GillesLACAUD/OPLA-OTHER-FILES/readme.md

______________________________________
 READ ME
 ______________________________________
