GillesLACAUD/OPLA-OTHER-FILES/05 Design/readme.md

______________________________________
Readme DESIGN NEXTION SCREEN
______________________________________

We can have two  different Nextion 2.4" screen

The Old one have a blue board for this one use the ES32_V2.HMI
BASIC SERIE NX3224T024_011

The new one is yellow use the ESP32V2_NEWSCREEN.HMI
DISCOVERY SERIE NX3224F024_11

The Nextion can be update with the nextion editor but you will need an USB to UART converter
Or you can generate the tft file in the editor, store it in the root folder of a SD-Card, insert this SD Card in the Nextion screen
then boot the nextion screen. 

Nextion editor and more informations here:
https://nextion.tech/
