GillesLACAUD/OPLA-OTHER-FILES/01 Hardware/IO_MAPPING.xlsx

P2 | IO21
 | IO22 | Midi RX
 | IO19 | Midi Tx
 | IO23 | Nextion TX
 | IO18 | Nextion Rx
 | IO5 | Arduino Tx
P3 | VDD
 | RXD0 | Download USB
 | TXD0 | Download USB
 | RST
 | IO0
P1 | JT MTDO
 | JT MTCK
 | IO12
 | IO14
