GillesLACAUD/OPLA-OTHER-FILES/05 Design/Acceuil.jpg

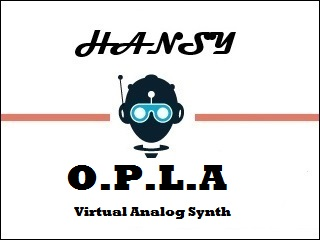
05 Design/Acceuil.jpg
