GillesLACAUD/OPLA-OTHER-FILES/08 Documentation/OPLA DIY MANUAL V1.2.pdf

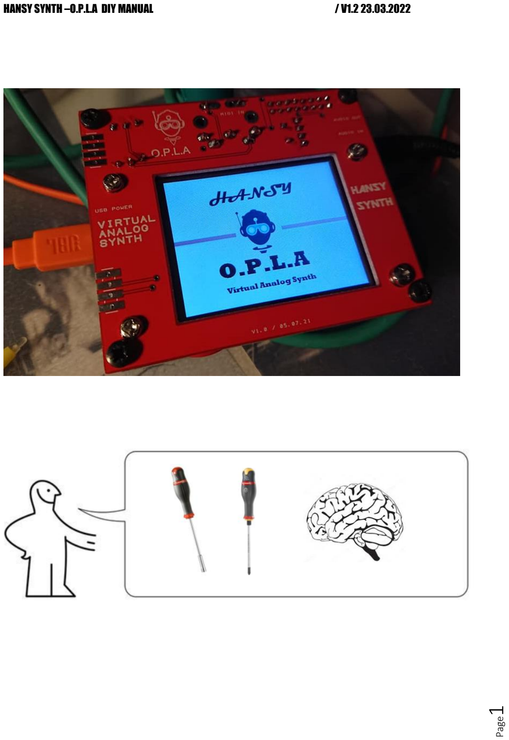
[picture p2: page 1]

HANSY SYNTH –O.P.L.A DIY MANUAL | / V1.2 23.03.2022

Page

1

Page

2

### Contents

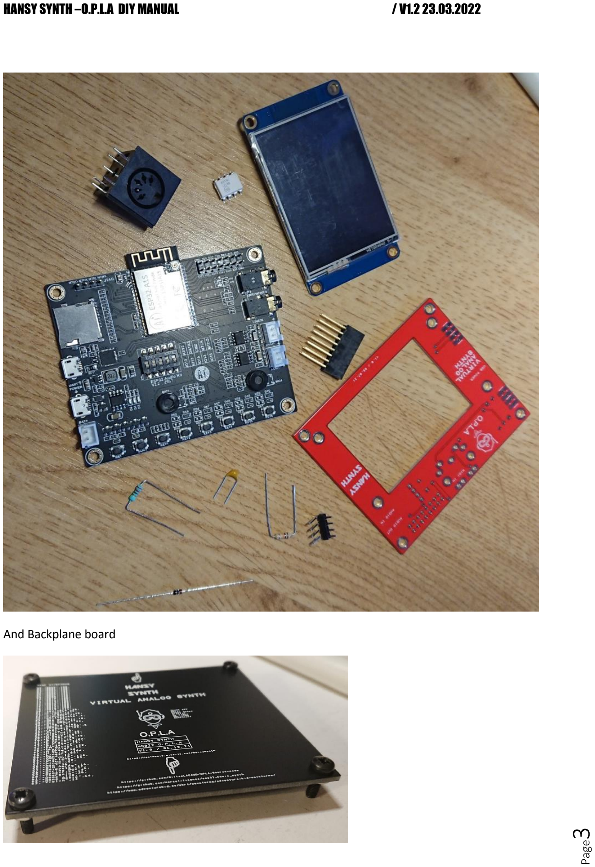
[picture p3: page 3]

Page

3

And Backplane board

Page

4

### BOM

DESIGNATION | QT
Screw M3*16 | 12
Nuts M3 | 20
Spacer M3*20 | 4
| DESIGNATION | QT
R1 | 200Ohm Resistor 1/4W | 1
R2 | 10KOhm Resistor 1/4W | 1
D1 | 1N4148 Diode | 1
C1 | 100nf Capacitor | 1
Q1 | 6N137 Optocoupleur | 1
PL1 | Four pin right angle connector | 1
| Midi 5 pin connector | 1
J1 | 2*8 pins PC104 Connector | 1
| Nextion screen | 1
| Hansy Synth HS021 Board | 1
| Hansy Synth HS022 Board (backplane) | 1
| ESP32 Audio Kit | 1
| Micro SD card < 64Go + SD support | 1
| Pen for the screen | 1
| USB cable | 1

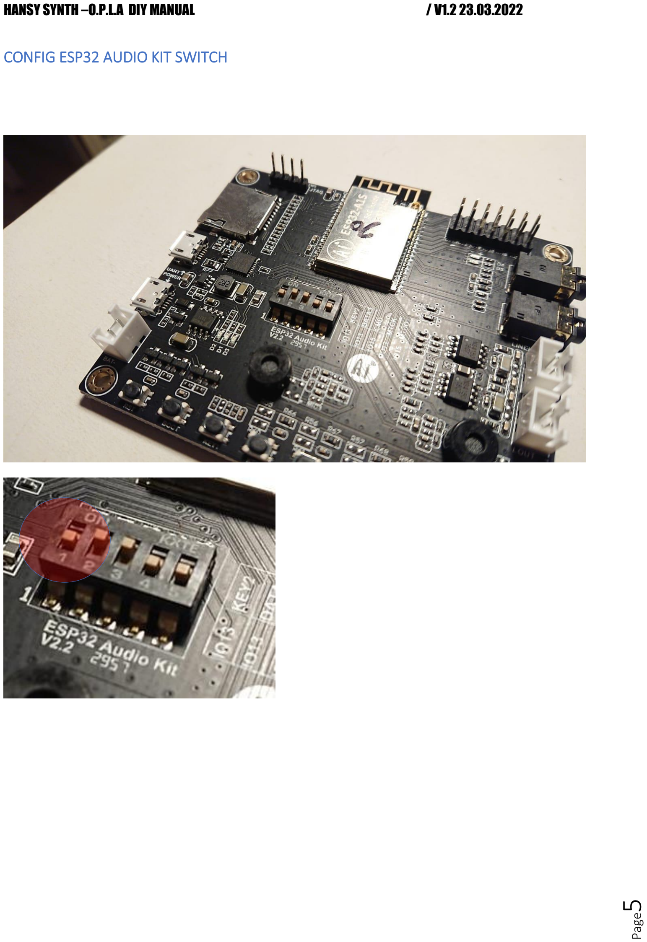
[picture p4: page 5]

Page

5

### CONFIG ESP32 AUDIO KIT SWITCH

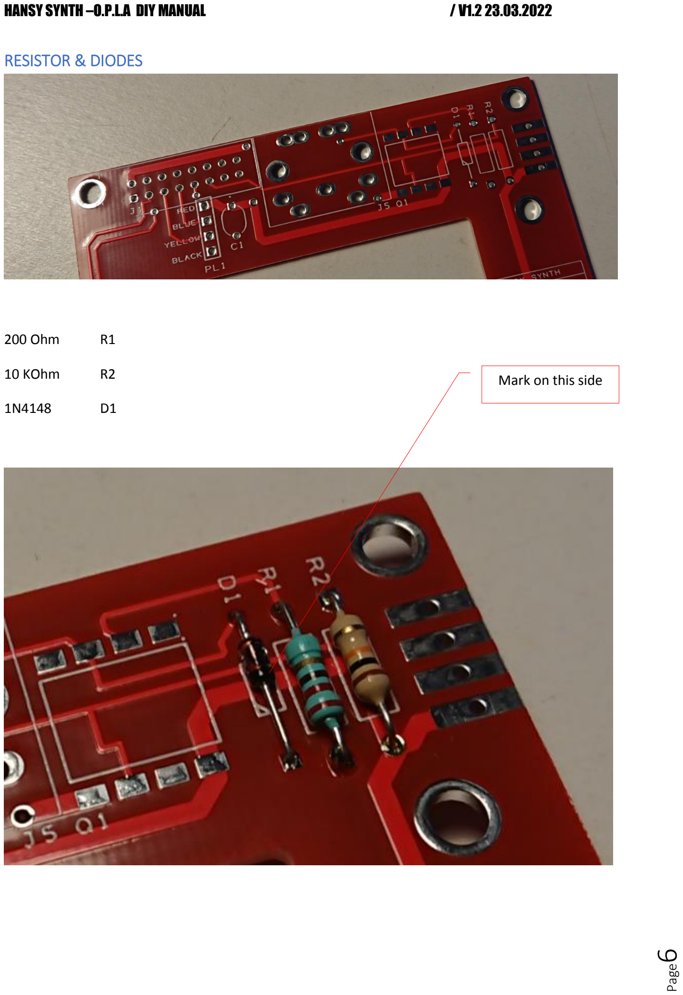
[picture p5: page 6]

Page

6

### RESISTOR & DIODES

200 Ohm | R1
10 KOhm | R2
1N4148 | D1

Mark on this side

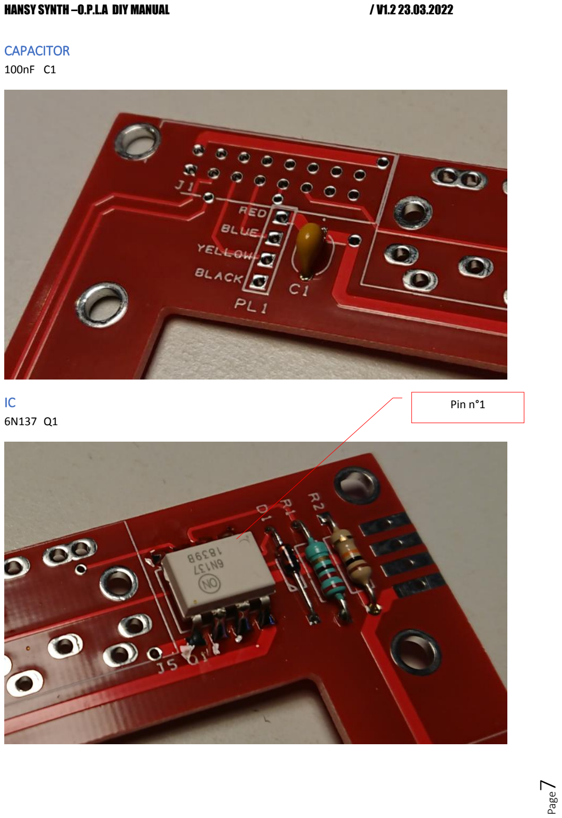
[picture p6: page 7]

Page

7

### CAPACITOR

100nF C1

IC
6N137 Q1

Pin n°1

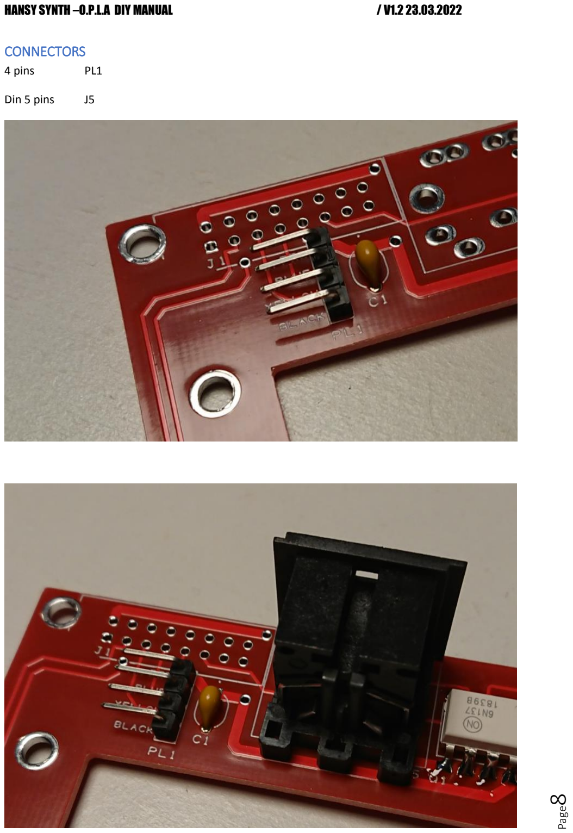
[picture p7: page 8]

Page

8

### CONNECTORS

4 pins | PL1
Din 5 pins | J5

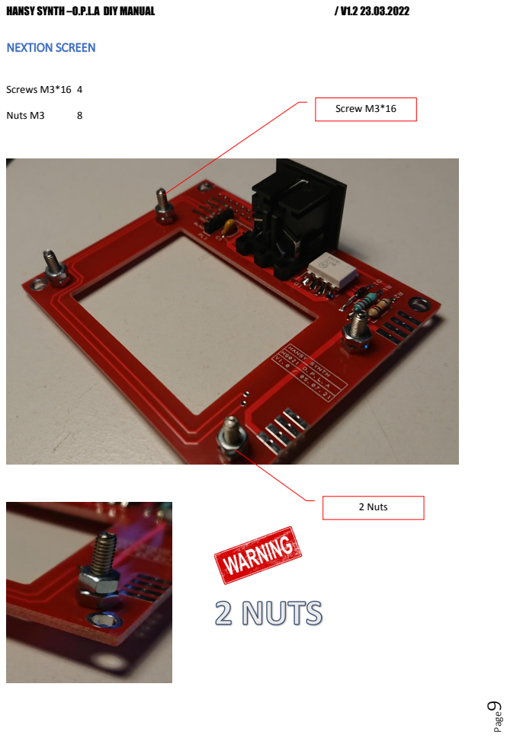
[picture p8: page 9]
Page; NEXTION SCREEN; Screws M3*16 4; Nuts M3; 2 Nuts; Screw M3*16

Page10

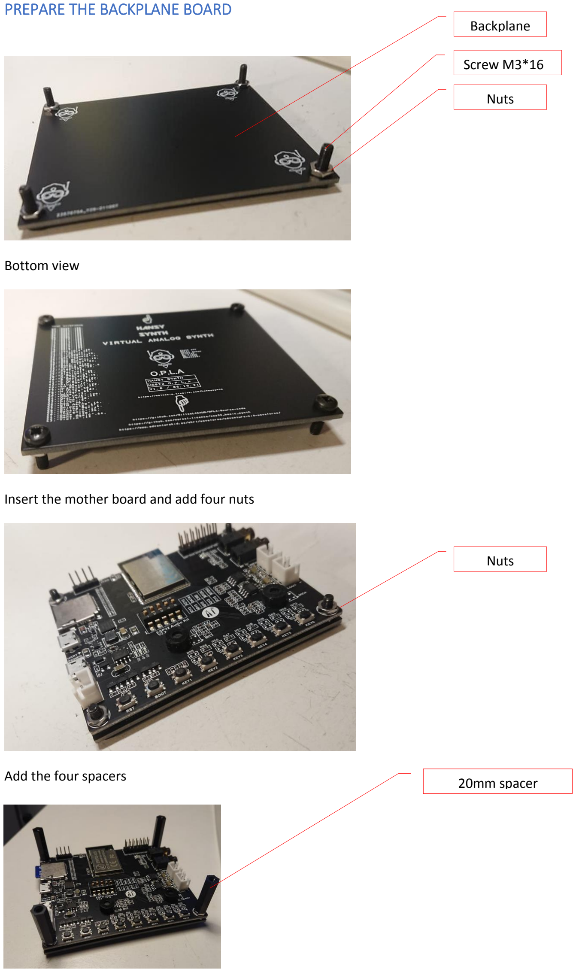
[picture p9: figure]
PREPARE THE BACKPLANE BOARD; Bottom view; Add the four spacers; Nuts; Screw M3*16; Backplane; 20mm spacer

Insert the mother board and add four nuts

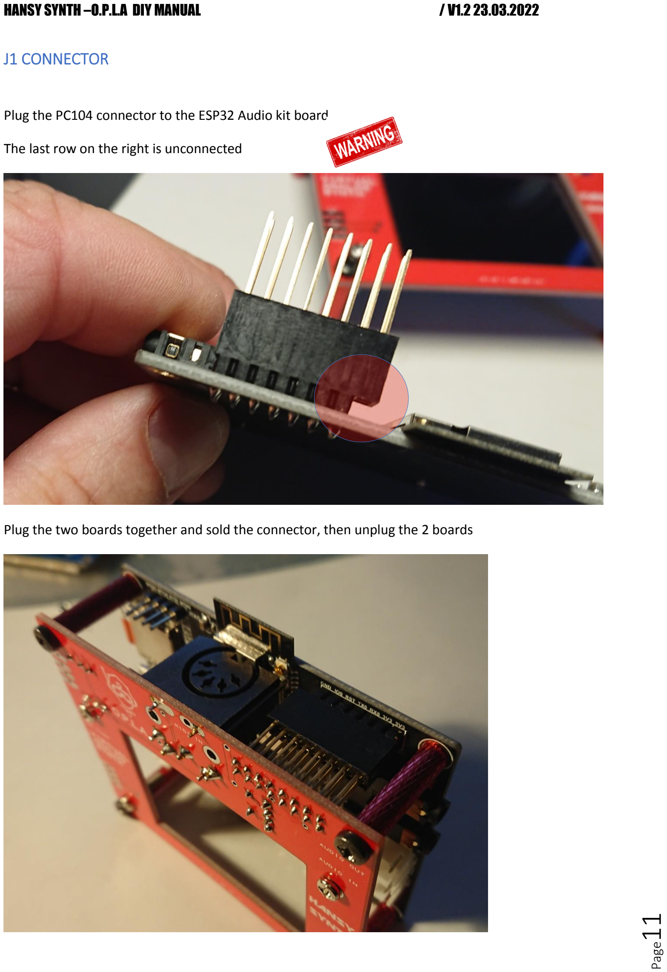
[picture p10: page 11]

Page11

### J1 CONNECTOR

Plug the PC104 connector to the ESP32 Audio kit board

The last row on the right is unconnected

Plug the two boards together and sold the connector, then unplug the 2 boards

Page12

### PROGRAM THE SD CARD

In the SD card you must have these files

You can find all these files in the github repository CLICK HERE (https://github.com/GillesLACAUD/OPLA-OTHER-FILES)

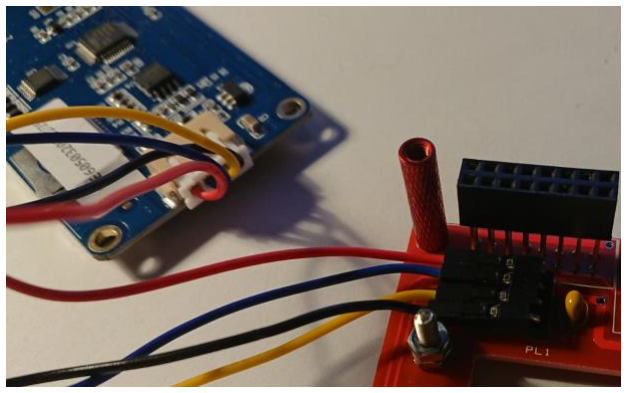
[picture p11: figure]

Page13

### PROGRAM THE NEXTION SCREEN

The Nextion screen is normally already programmed.

Go to the next chapter INSERT THE NEXTION SCREEN

Insert the connector in the Nextion screen

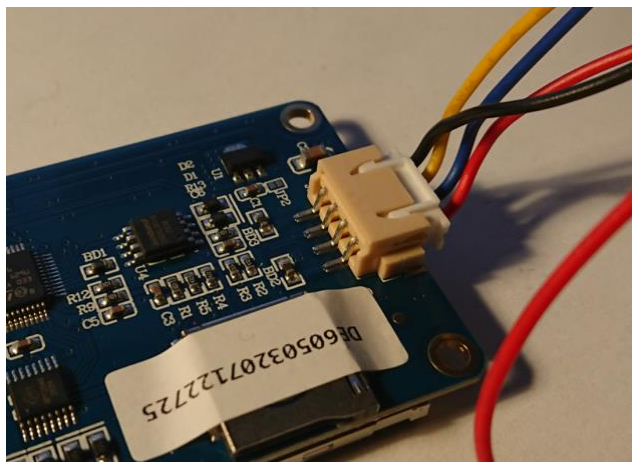
[picture p12: figure]

Connect the PL1. The colors of the wires are writing in the board

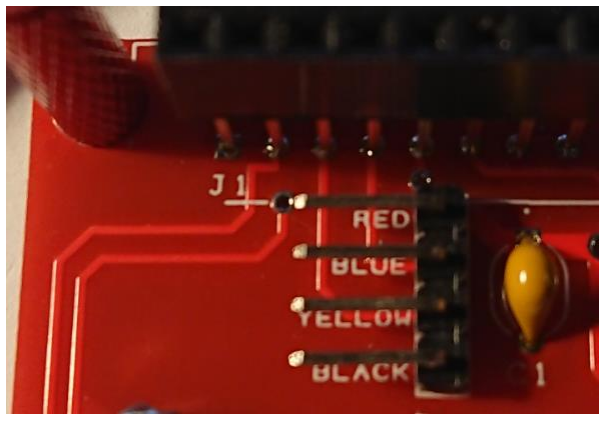
[picture p13: figure]
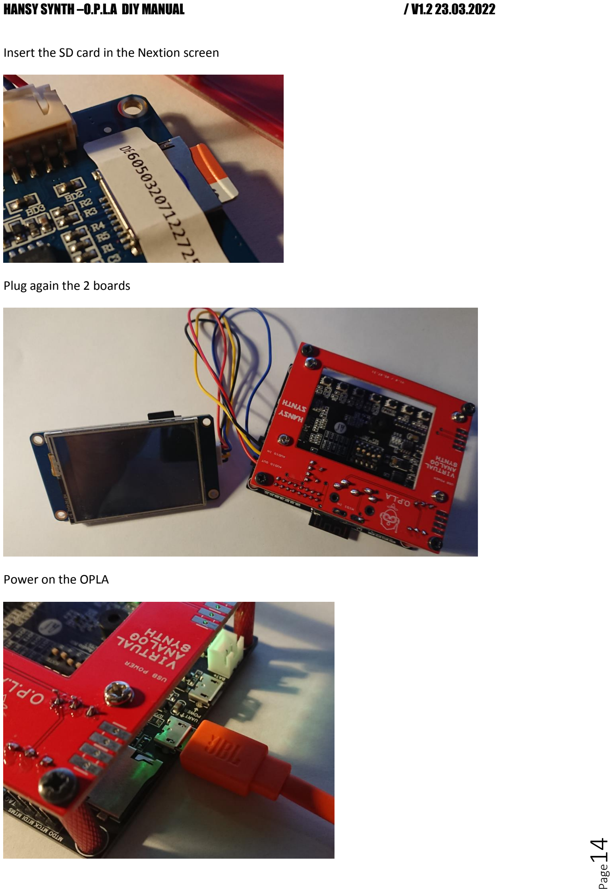
[picture p14: page 14]

Page14

Insert the SD card in the Nextion screen

Plug again the 2 boards

Power on the OPLA

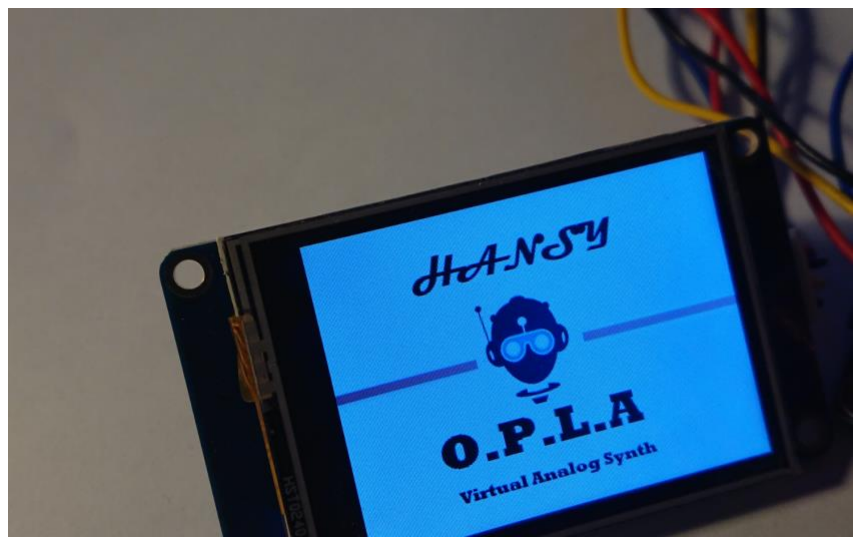
[picture p15: figure]

Page15

After some seconds you must see something like that

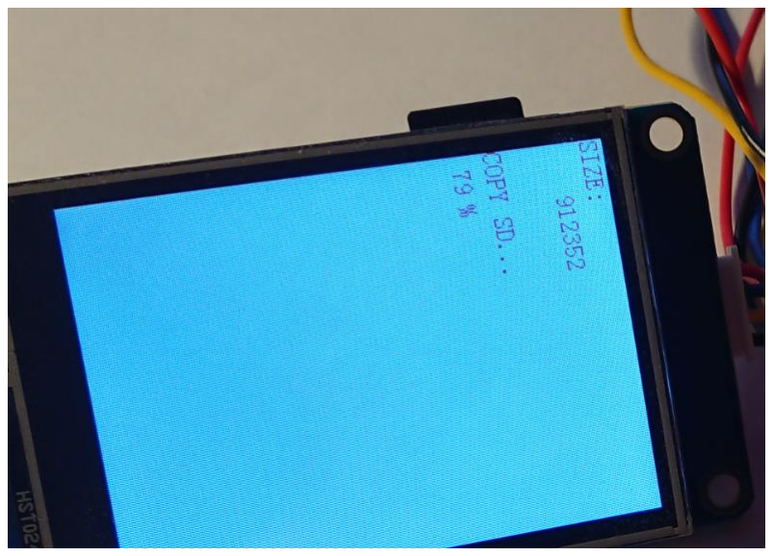
[picture p16: figure]

Then

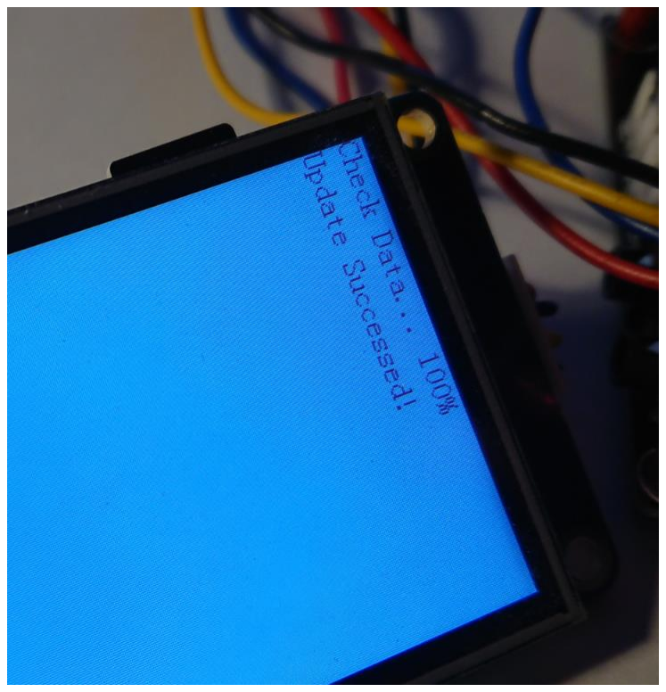
[picture p17: figure]

Unplug the SD Card / Power off and on the OPLA. The screen must start with the OPLA main screen

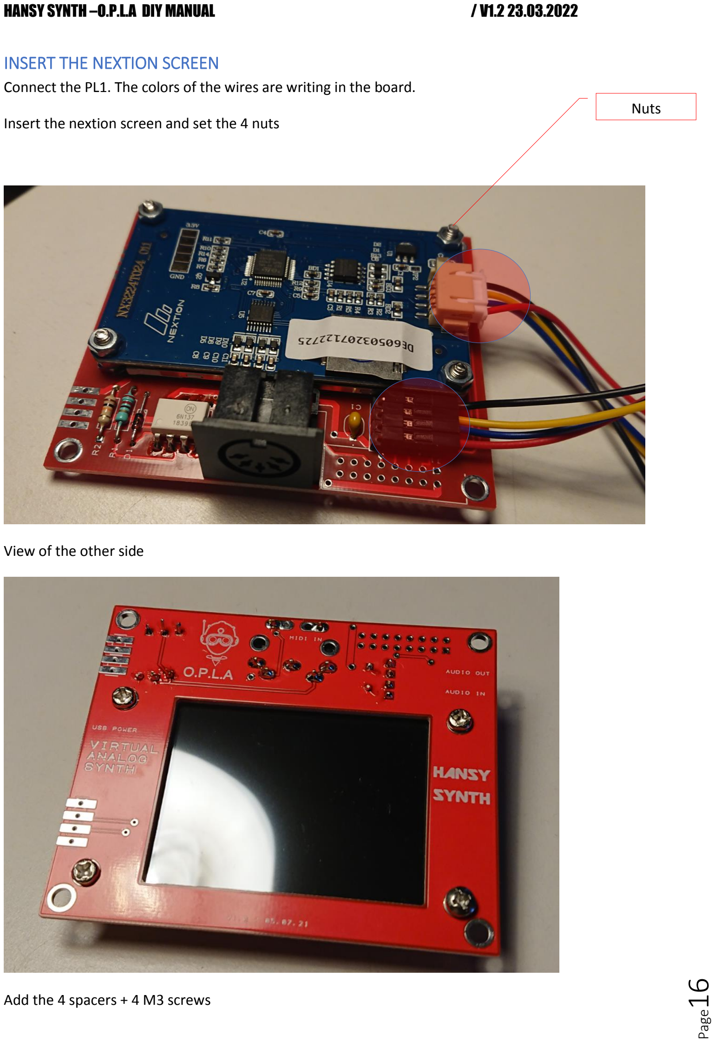
[picture p18: page 16]

Page16

### INSERT THE NEXTION SCREEN

Connect the PL1. The colors of the wires are writing in the board.

Insert the nextion screen and set the 4 nuts

View of the other side

Add the 4 spacers + 4 M3 screws

Nuts

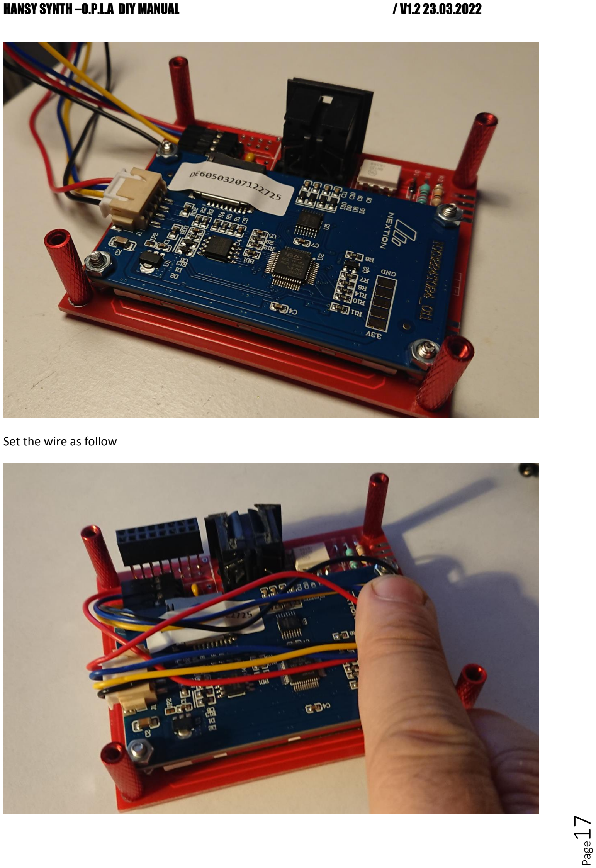
[picture p19: page 17]

Page17

Set the wire as follow

Page18

Then plug the other card and add the last 4 screws

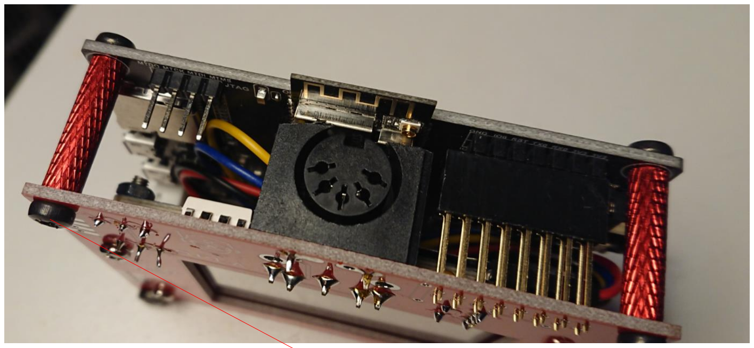
[picture p20: figure]

Screw M3*16

Page19

### PROGRAM THE OPLA MULTI FILE VERSION

The Mother Board is normally already programmed.

Go to the next chapter INSERT THE NEXTION SCREEN

In the OPLA Mother Board there is an USB to UART converter.

If you have any issue to update your OPLA please check if the windows driver is well installed on your PC

If not you can find it here:

https://www.silabs.com/developers/usb-to-uart-bridge-vcp-drivers (CP210x Universal Windows Driver)

Please use the “Program OPLA with one file Version” for a better and easier way.

The different firmware can be finding here:

https://github.com/GillesLACAUD/OPLA-Source-code/tree/master/Firmware_Bin

The last version 23.03.2022 is the targetV15.bin

Page20

Plug the SD card in the ESP32 Audio Kit board (not mandatory) Download the ESP32 Flash download tool here. (https://www.espressif.com/en/support/download/other-tools)

Unzip the file

Click on the file flash_download_tool_3.8.8.exe

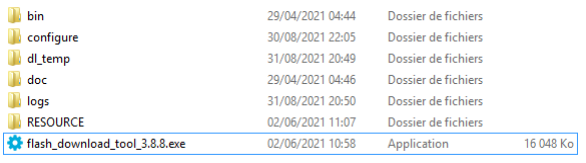
[picture p21: figure]

Select ESP32 for the chip type

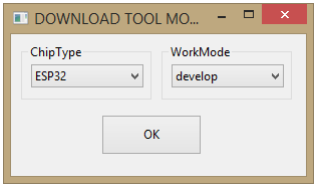
[picture p22: figure]

Bootloaderfile address 0x1000 | bootloader_dio_40m.bin
Partition file address | 0x8000 | partitions.bin
Partition boot address 0xe000 | boot_app0.bin
Firmware address | 0x10000 | firmware.bin
Chrystal 40M
Baud rate 460800
Flash size 4MB
Load the different .bin files and set the address. Check the box on the left for the four files
Set the com port. It can be different from COM9 Set the Baud rate at 460800

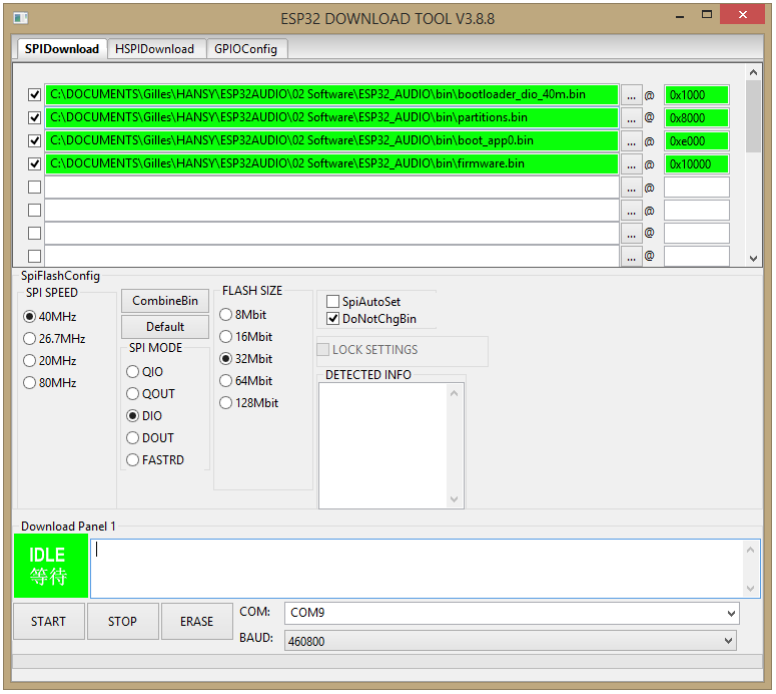
[picture p23: figure]

Page21

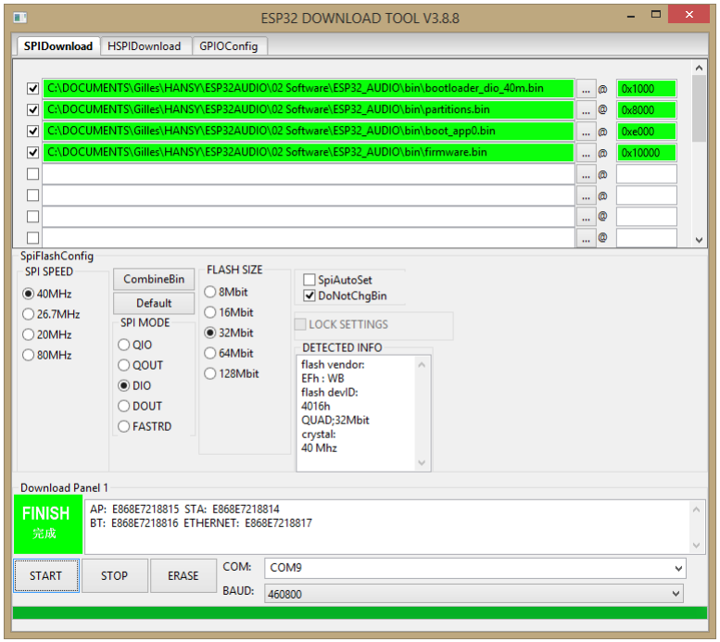
[picture p24: figure]

Page22

Click on start after 10 seconds you must see this screen

Page23

### PROGRAM THE OPLA WITH ONE FILE VERSION

The four file can be combine to just one file with the Combinebin button

The result is a target.bin file

Load this file, set the address to 0x00 and uncheck the DoNotChgBin button

Click on start

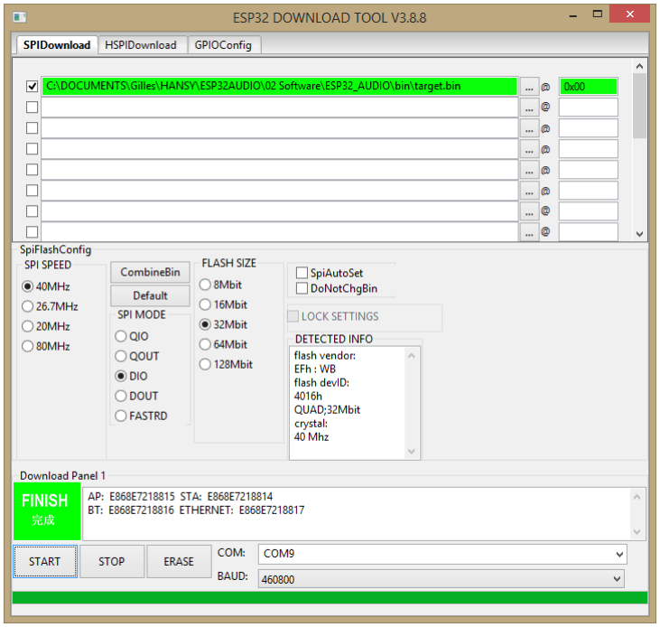
[picture p25: figure]

Page24

### TEST AND CALIBRATION

Plug the Midi Din connector

Plug a Headphone on the Audio out jack

Plug the Mini USB connector

Check if the SD card is inserted

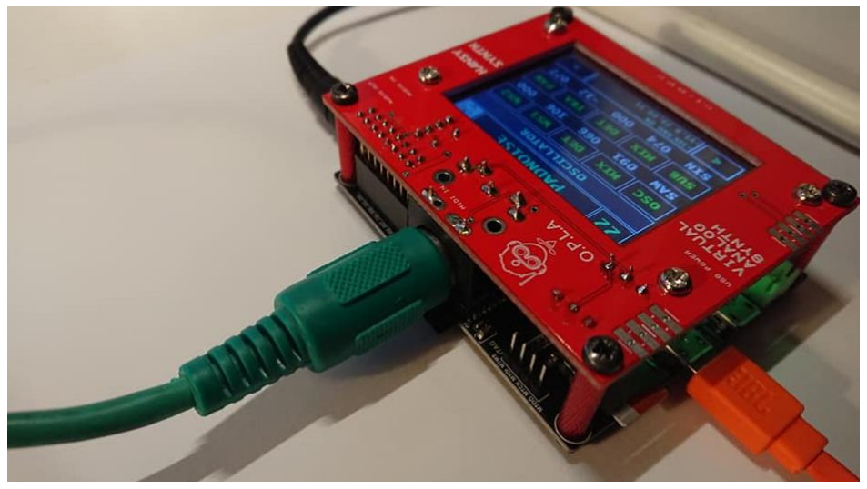
[picture p26: figure]

- The OPLA Must start

Connect a Midi Keyboard with a Midi Channel 1
Hit some Key and test if you see the number of key in the bottom lines of the screen

Test if you have some sound on your headphone.

To Calibrate the Nextion screen go to the FX section or MIDI-MISC for the firmware version above V15, select CAL then set the cursor to yes and follow the instructions
