GillesLACAUD/OPLA-OTHER-FILES/(list of files, drawings)

Other design files:
01 Hardware/BackPCB/ESP32.pcb
01 Hardware/BackPCB/~ESP32.pcb
01 Hardware/V1.0 With Pot/ESP32.pcb
01 Hardware/V1.0 With Pot/~ESP32.pcb
