GillesLACAUD/OPLA-OTHER-FILES/(commit log)

2021-08-31 Add Hardware files
    [ESP32 - Board.gbr, ESP32 - Bottom Copper.gbr, ESP32 - Bottom Paste Mask.gbr, ESP32 - Bottom Silkscreen.gbr, ESP32 - Bottom Solder Mask.gbr, ESP32 - Drill Data - [Through Hole] (Unplated).drl, ESP32 - Drill Data - [Through Hole].drl, ESP32 - Drill Ident Drawing - [Through Hole].gbr]
2021-10-06 Add BackPCB files
    [ESP32 - Board.gbr, ESP32 - Bottom Copper.gbr, ESP32 - Bottom Paste Mask.gbr, ESP32 - Bottom Silkscreen.gbr, ESP32 - Bottom Solder Mask.gbr, ESP32 - Drill Data - [Through Hole] (Unplated).drl, ESP32 - Drill Data - [Through Hole].drl, ESP32 - Drill Ident Drawing - [Through Hole].gbr]
2021-10-07 Add BOM
    [OPLA BOM.xlsx]
2021-11-11 Add files via upload
    Add doc files
    [BOM.xlsx]
2021-11-11 Delete BOM.xlsx
    del BOM
    [BOM.xlsx]
2022-03-04 Update ESP32_V2.HMI and add ESP32V2_NEWSCREEN.HMI
2022-03-23 Update DIY Manual for CP1202 Driver
